AffordableEducationRobot/v1.0/README.md

#AERobot v1.0

Copyright (C) 2014-2015 Wyss Institute (http://wyss.harvard.edu)
This project is licensed under a Creative Commons Attribution 4.0 International License. (CC BY 4.0)
