AffordableEducationRobot/v1.0/electr/gerber/readme.txt

Notes:

- The PCB1.TXT file is the drill file.
