AffordableEducationRobot/v1.0/doc/pads/lineFollowingBasicPad.png

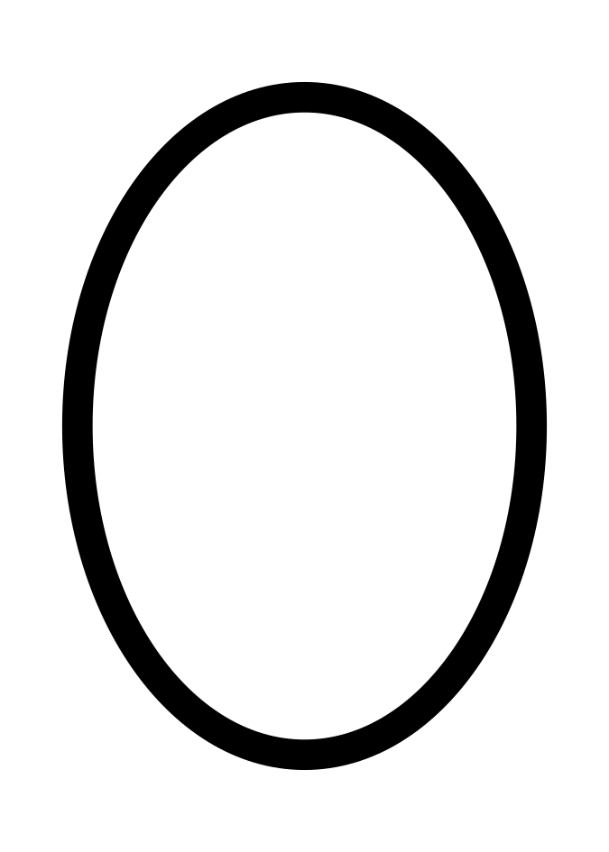
doc/pads/lineFollowingBasicPad.png
