AffordableEducationRobot/v1.0/electr/bom/bom.xlsx

designator | part number | source | note
1 | 1080-1378 | www.digikey.com | ir / ambient sensor
b1 | 3008KCT | www.digikey.com | batteryholder
batterycharge | MCP73812T | www.digikey.com | charger
c1 | 587-1785-1-ND | www.digikey.com | capacitor (4.7uf)
c10 | 587-1785-1-ND | www.digikey.com | capacitor (4.7uf)
c11 | 587-1785-1-ND | www.digikey.com | capacitor (4.7uf)
c12 | 1276-1089-1-ND | www.digikey.com | xtal cap
c13 | 1276-1089-1-ND | www.digikey.com | xtal cap
c6 | 587-1785-1-ND | www.digikey.com | capacitor (4.7uf)
c7 | 587-1785-1-ND | www.digikey.com | capacitor (4.7uf)
c8 | 587-1785-1-ND | www.digikey.com | capacitor (4.7uf)
irled5 | 1080-1354-2-ND | www.digikey.com | line sensor tx
ld | 638-ir12-21c | www.mouser.com | ir led
led2 | 638-ir12-21c | www.mouser.com | ir led
led4 | 638-ir12-21c | www.mouser.com | ir led
m1 | rb-sbo-100 | www.robotshop.com | motor
m2 | rb-sbo-100 | www.robotshop.com | motor
mcu | ATMEGA168A | www.mouser.com | mcu
md | a3901sejtr | allegro | hbridge
r1 | 311-150DTR-ND | www.digikey.com | resistor (150 ohm)
r11 | RR08P31.6KDCT-ND | www.digikey.com | resistor (31 kohm)
r13 | RR08P31.6KDCT-ND | www.digikey.com | resistor (31 kohm)
r14 | RR08P31.6KDCT-ND | www.digikey.com | resistor (31 kohm)
r16 | RR08P31.6KDCT-ND | www.digikey.com | resistor (31 kohm)
r17 | RR08P31.6KDCT-ND | www.digikey.com | resistor (31 kohm)
r18 | 311-68GRTR-ND | www.digikey.com | resistor (68 ohm)
r19 | 311-68GRTR-ND | www.digikey.com | resistor (68 ohm)
r20 | RMCF0603JT1K50CT-ND | www.digikey.com | resistor (1.5 kohm)
r21 | 311-10KGRTR-ND | www.digikey.com | resistor (10 kohm)
r24 | 311-10KGRTR-ND | www.digikey.com | resistor (10 kohm)
r25 | 311-10KGRTR-ND | www.digikey.com | resistor (10 kohm)
r26 | 311-40.2HRCT-ND | www.digikey.com | resistor (40.2 ohm)
r27 | 311-40.2HRCT-ND | www.digikey.com | resistor (40.2 ohm)
r28 | 311-40.2HRCT-ND | www.digikey.com | resistor (40.2 ohm)
r29 | 311-10KGRTR-ND | www.digikey.com | resistor (10 Kohm)
r3 | 311-150DTR-ND | www.digikey.com | resistor (150 ohm)
r30 | 311-10KGRTR-ND | www.digikey.com | resistor (10 Kohm)
r42 | P.56AJTR-ND | www.digikey.com | resistor (0.56 ohm)
r43 | RR08Q68DCT-ND | www.digikey.com | resistor (68 ohm) 0.5%
r44 | P.56AJTR-ND | www.digikey.com | resistor (0.56 ohm)
r45 | RR08Q68DCT-ND | www.digikey.com | resistor (68 ohm) 0.5%
r46 | P.56AJTR-ND | www.digikey.com | resistor (0.56 ohm)
r47 | RR08Q68DCT-ND | www.digikey.com | resistor (68 ohm) 0.5%
r5 | 311-150DTR-ND | www.digikey.com | resistor (150 ohm)
r8 | erj-3ekf2000v | www.digikey.com | resistor (200 ohm)
reg1 | 1219-1084-2-ND | www.digikey.com | regulator
reg2 | 1219-1084-2-ND | www.digikey.com | regulator
reg3 | 1219-1084-2-ND | www.digikey.com | regulator
rgbdriver | 595-TLC59731d | www.mouser.com | rgb driver
rgbled | 160-2022 | www.digikey.com | rgb led
rx2 | 1080-1378 | www.digikey.com | ir / ambient sensor
rx4 | 1080-1378 | www.digikey.com | ir / ambient sensor
rx6 | 1080-1381 | www.digikey.com | line sensor rx
rx8 | 1080-1381 | www.digikey.com | line sensor rx
s1 | 506-1571634-2 | www.mouser.com | pushbutton switch
t3 | 568-1633-1-ND | www.digikey.com | led driver transistor
t7 | mmbt3906fsct | www.digikey.com | led driver transistor
t8 | mmbt3906fsct | www.digikey.com | led driver transistor
t9 | mmbt3906fsct | www.digikey.com | led driver transistor
x1 | 535-10283-1-ND | www.digikey.com | xtal
c5 | no component
c3 | no component
c2 | no component
