AffordableEducationRobot/v1.0/mech/laserCut/foot.dxf

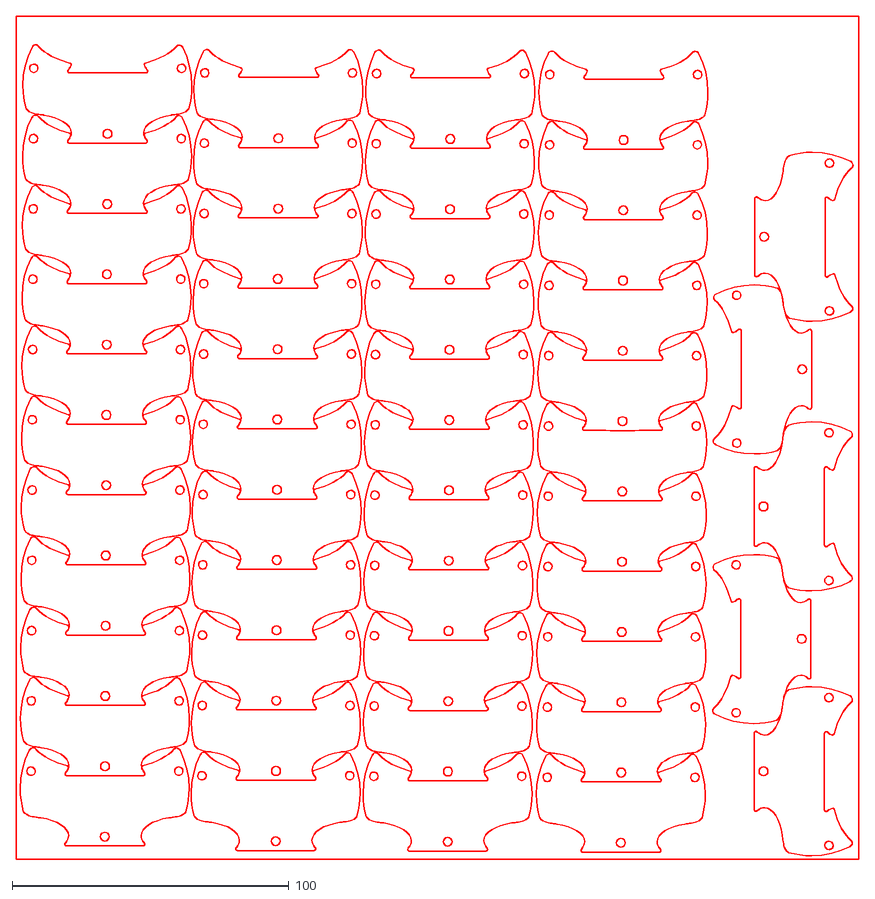
[picture p2: CAD file, 2015-09-18]
mech/laserCut/foot.dxf
304.5 x 304.5
