AffordableEducationRobot/v1.0/electr/pdf/Schematic.pdf

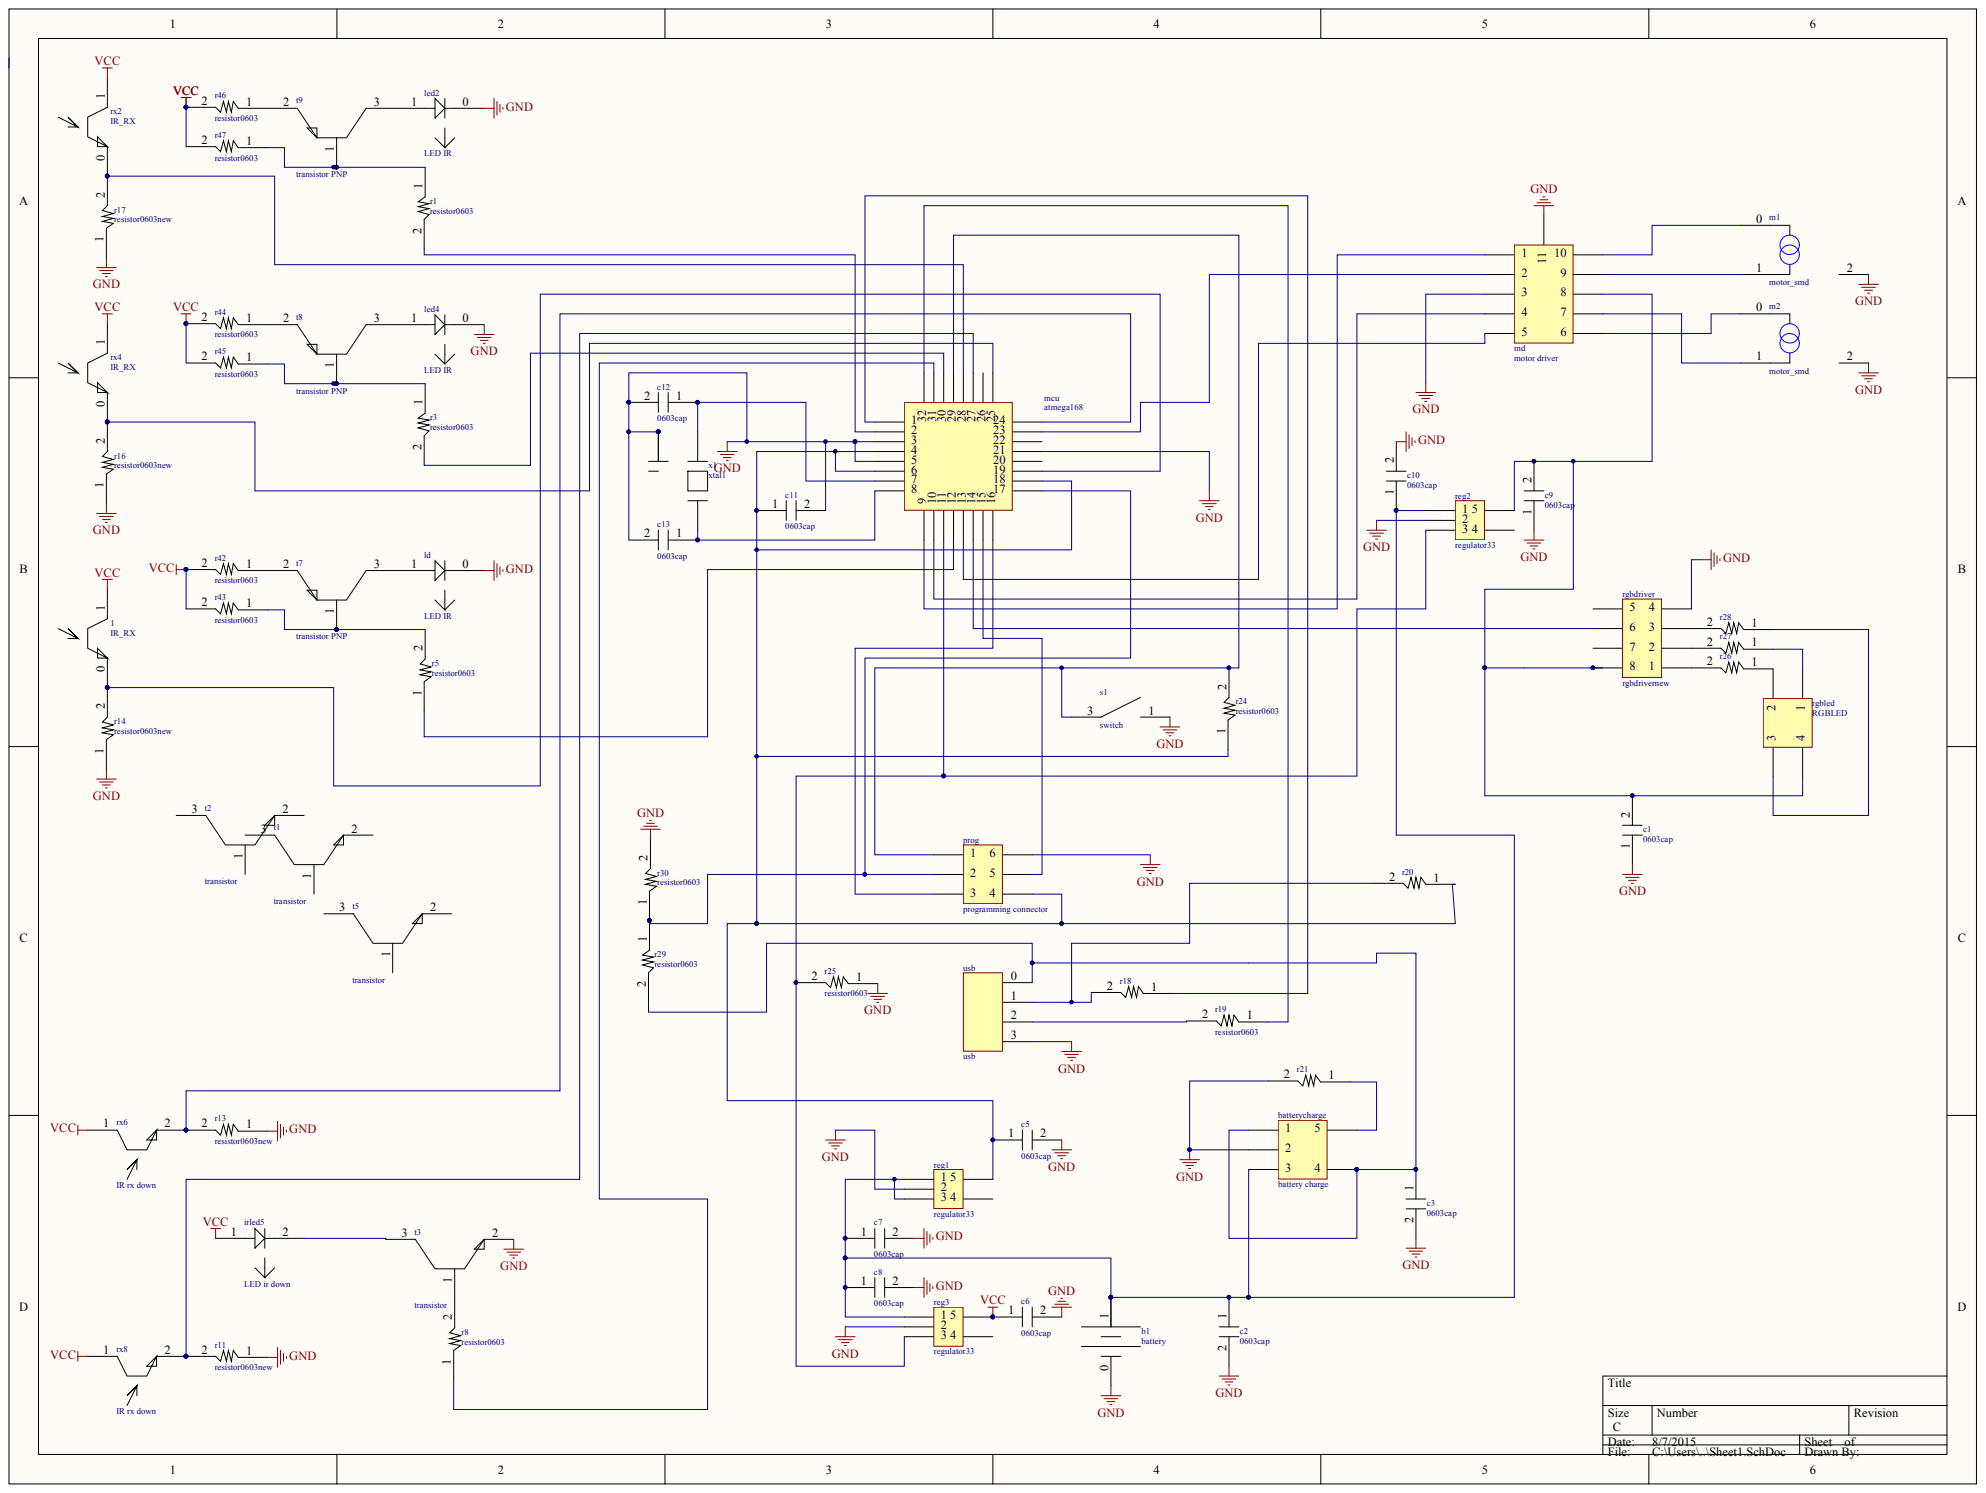
[picture p3: page 1]

c10 | md motor driver

LED IR

resistor0603

GND

programming connector
