AffordableEducationRobot/v1.0/electr/pdf/PCB1.pdf

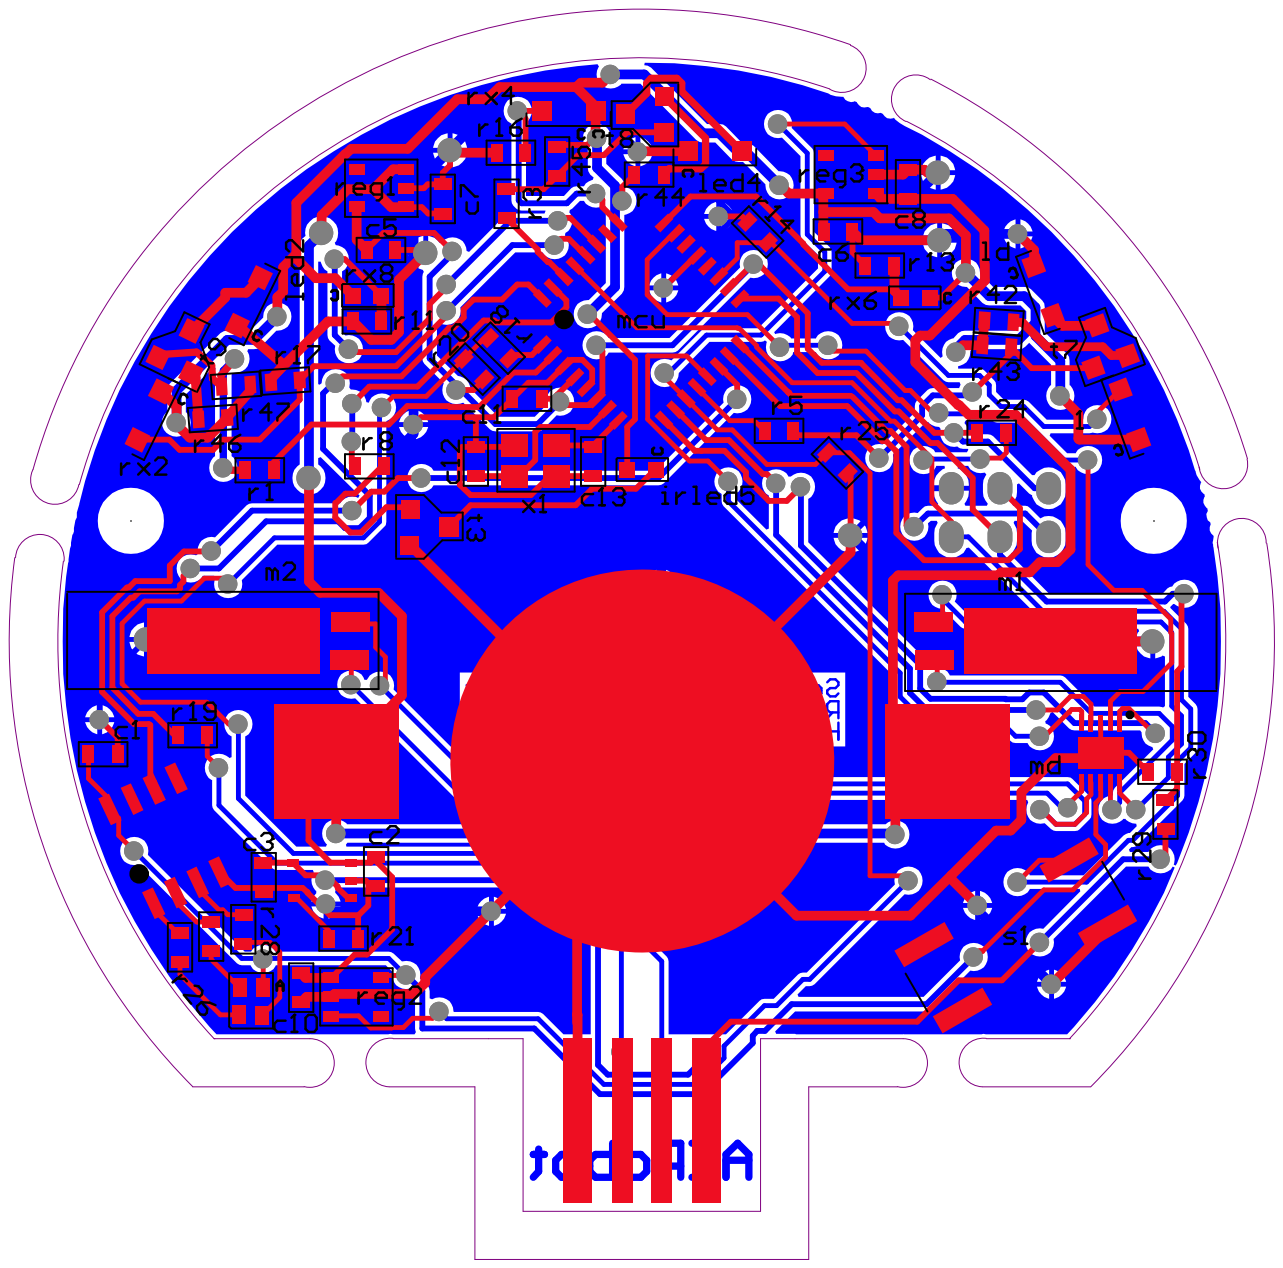
[picture p4: page 1]
