AffordableEducationRobot/v1.0/electr/pdf/PCB2.pdf

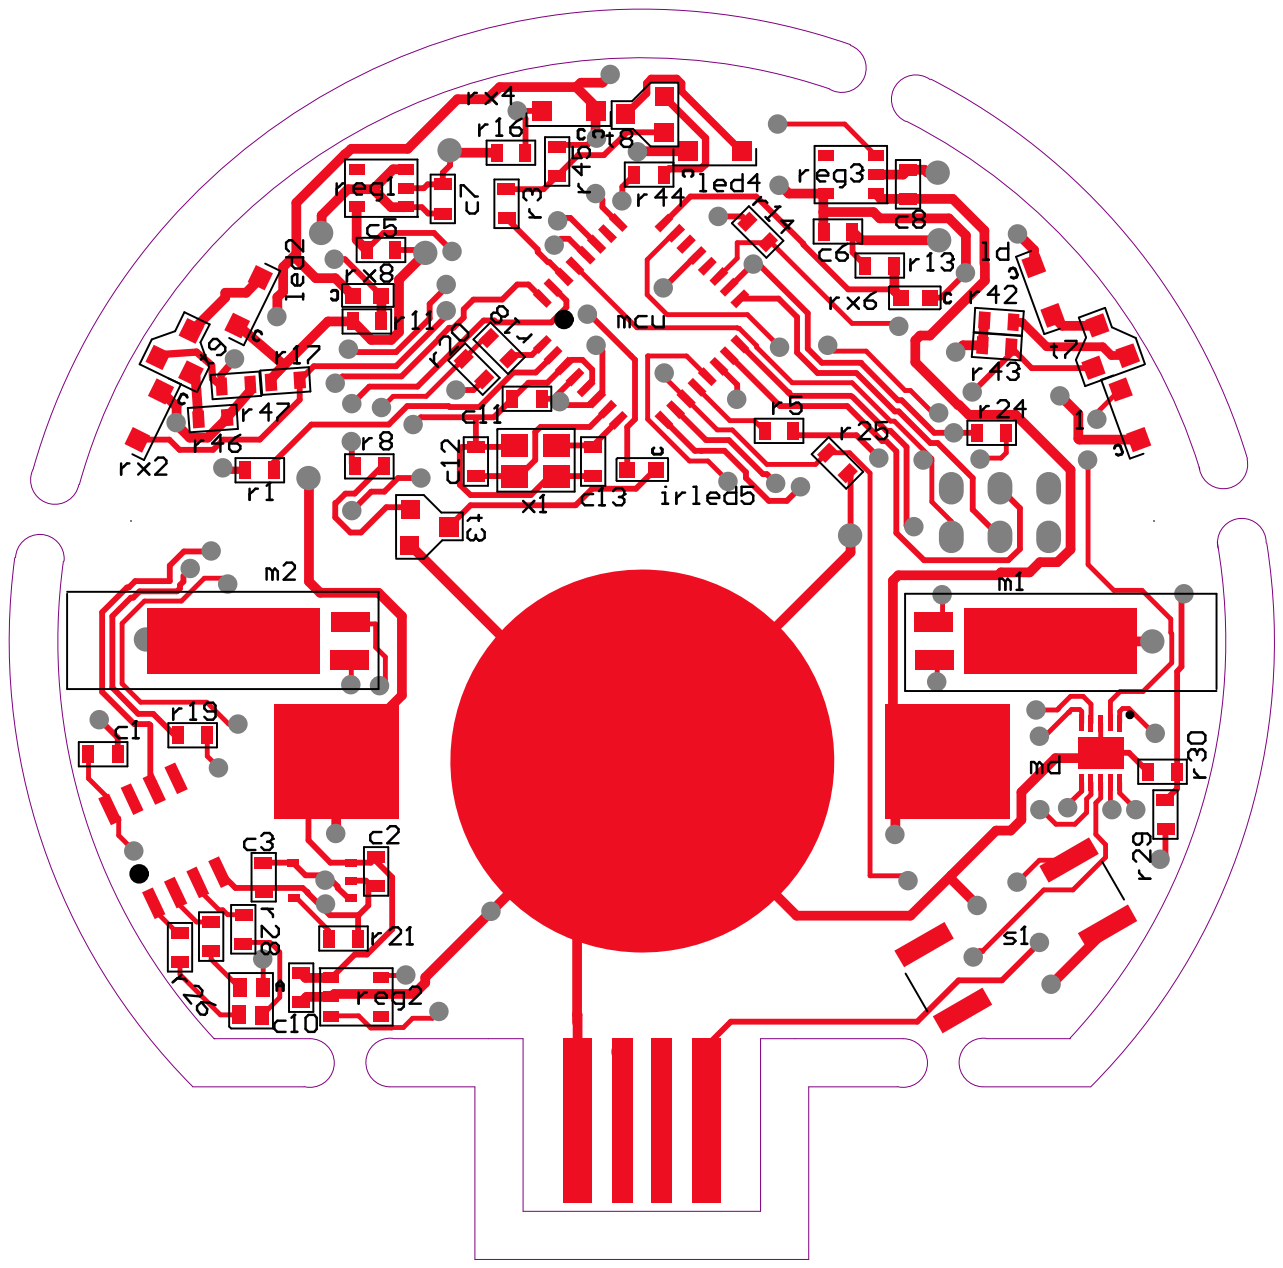
[picture p5: page 1]
