AffordableEducationRobot/v1.0/(list of files, drawings)

Other design files:
electr/altium/PCB1.PcbDoc
electr/altium/PcbLib1.PcbLib
electr/altium/Schlib1.SchLib
electr/altium/Sheet1.SchDoc
