AffordableEducationRobot/v1.0/doc/pads/lineFollowingCalibrationPad.png

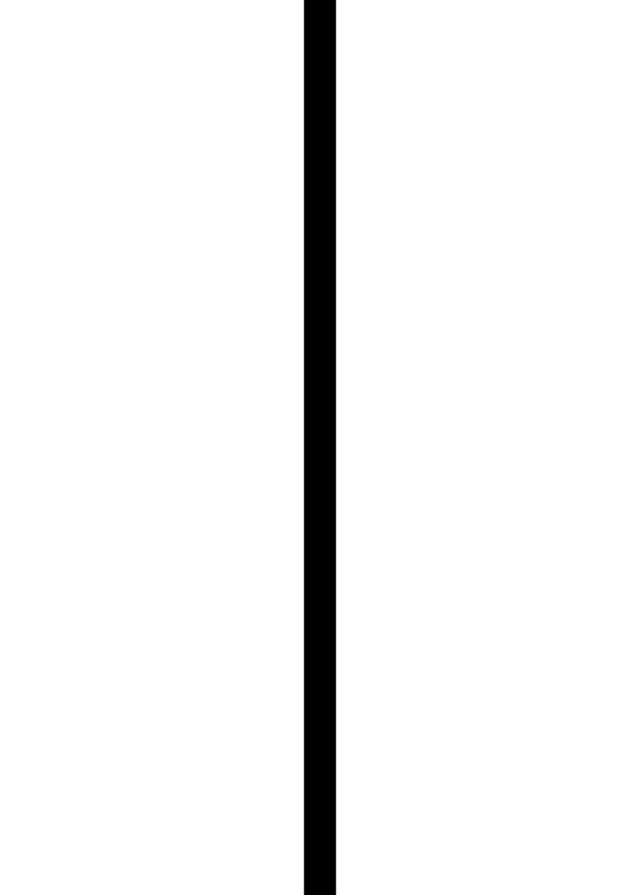
doc/pads/lineFollowingCalibrationPad.png
