AffordableEducationRobot/v1.0/(commit log)

2015-08-07 Second commit.
    [PCB1.PcbDoc, PcbLib1.PcbLib, Schlib1.SchLib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]
2015-08-07 Schematic PDF added.
2015-08-07 readme.txt added go the Gerber directory.
2015-08-07 Modified /soft dir structure and bootloader name (added release date to keep track of the version).
2015-08-10 PCB PDFs added.
2015-08-13 New dir structure.
    [PCB1.PcbDoc, PcbLib1.PcbLib, Schlib1.SchLib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]
2015-09-25 New electronics dir structure
    [PCB1.PcbDoc, PcbLib1.PcbLib, Schlib1.SchLib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]
2015-09-28 Calibration and basic line following pad added.
